EXiciuTE/Nixie-Clock-ESP32/HARDWARE/Nixie_Clock_ESP32_IN14.pdf

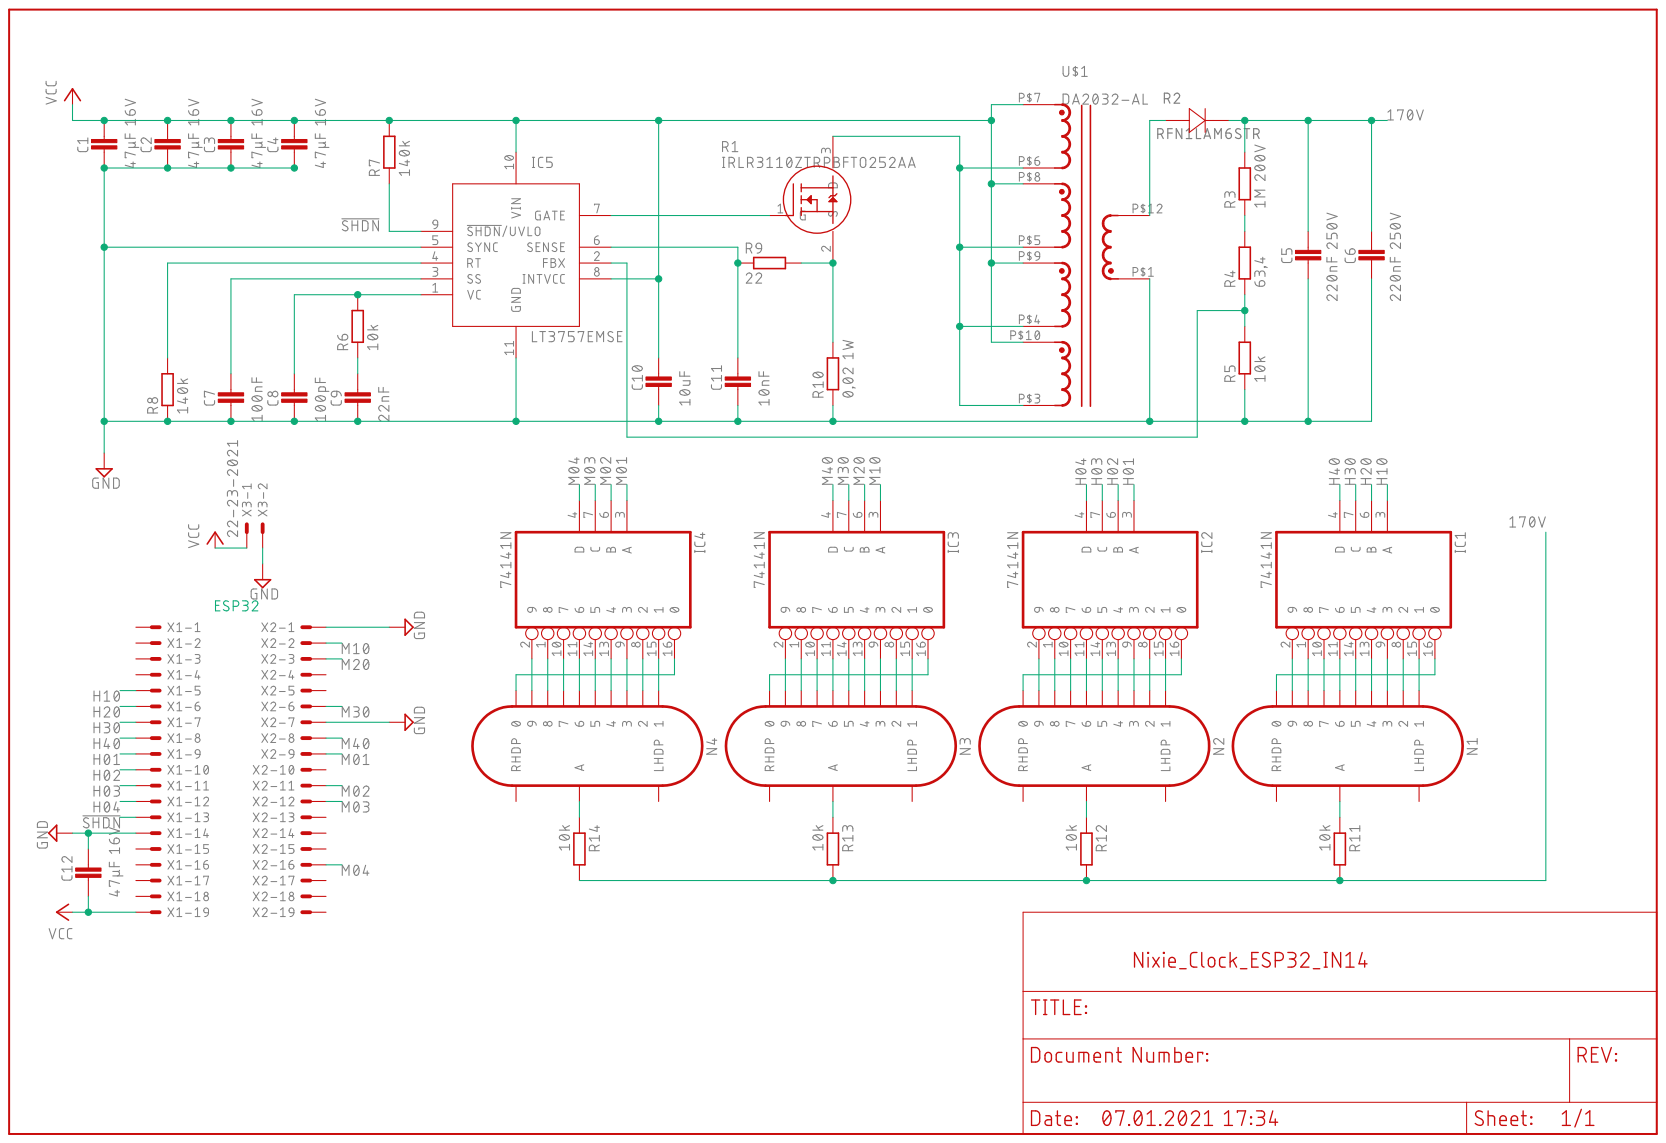
[picture p1: page 1]
