EXiciuTE/Nixie-Clock-ESP32/HARDWARE/Nixie_Clock_ESP32_IN14.brd

## EAGLE design HARDWARE/Nixie_Clock_ESP32_IN14.brd (2025-07-21)

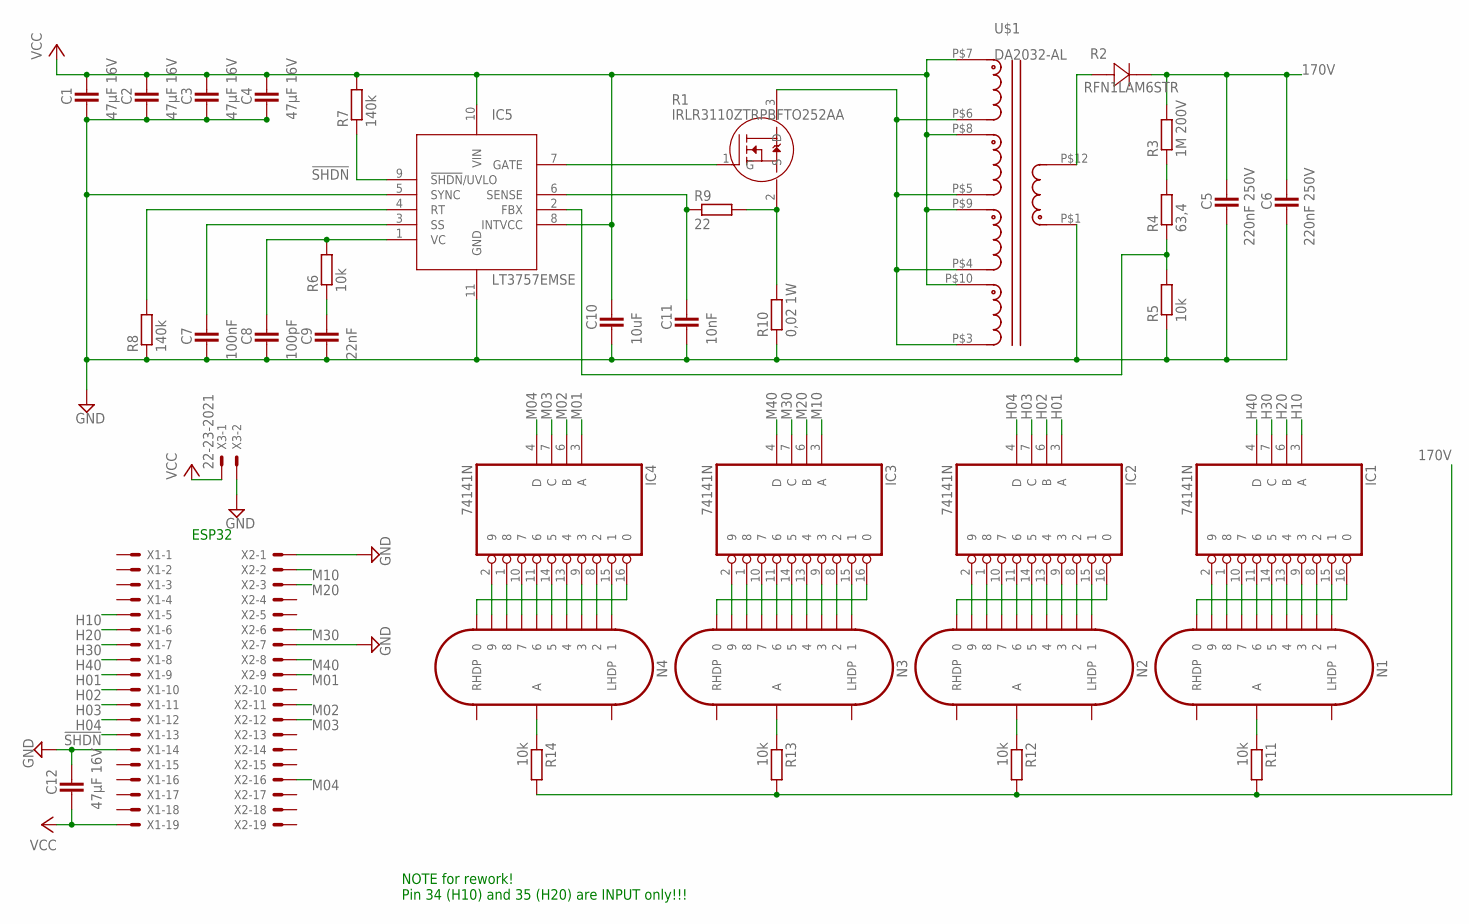
[picture p2: schematic Nixie_Clock_ESP32_IN14.sch]

Parts:
C1, C2, C3, C4, C12: 47µF 16V; C1210
C5, C6: 220nF 250V; C1206
C7: 100nF; C0805
C8: 100pF; C0805
C9: 22nF; C0805
C10: 10uF; C0805
C11: 10nF; C0805
IC1, IC2, IC3, IC4: 74141N; DIL16
IC5: LT3757EMSE; MSOP10
N1, N2, N3, N4: IN-14
R1: IRLR3110ZTRPBFTO252AA; TO252
R2: RFN1LAM6STR; DIO_RB050LAM_ROM
R3: 1M 200V; R0805
R4: 63,4; R0805
R5, R6, R11, R12, R13, R14: 10k; R0805
R7, R8: 140k; R0805
R9: 22; R1206
R10: 0,02 1W; R2010
U$1: DA2032-AL
X1, X2: C-GRID-19-70543; 70543-19
X3: 22-23-2021

Connections:
170V: C5.1, C6.1, R2.1 (0), R3.2, R11.2, R12.2, R13.2, R14.2
!SHDN: IC5.9 (!SHDN!/UVLO), R7.1, X1.13
GND: C1.2, C2.2, C3.2, C4.2, C5.2, C6.2, C7.2, C8.2, C9.2, C10.2, C11.2, C12.1, IC1.12 (GND), IC2.12 (GND), IC3.12 (GND), IC4.12 (GND), IC5.5 (SYNC), IC5.11 (GND), R5.1, R8.1, R10.1, U$1.P$1 (1), X1.14, X2.1, X2.7, X3.2
H01: IC2.3 (A), X1.9
H02: IC2.6 (B), X1.10
H03: IC2.7 (C), X1.11
H04: IC2.4 (D), X1.12
H10: IC1.3 (A), X1.5
H20: IC1.6 (B), X1.6
H30: IC1.7 (C), X1.7
H40: IC1.4 (D), X1.8
M01: IC4.3 (A), X2.9
M02: IC4.6 (B), X2.11
M03: IC4.7 (C), X2.12
M04: IC4.4 (D), X2.16
M10: IC3.3 (A), X2.2
M20: IC3.6 (B), X2.3
M30: IC3.7 (C), X2.6
M40: IC3.4 (D), X2.8
unnamed: IC1.16 (0), N1.0
unnamed: R1.3 (D), U$1.P$3 (3), U$1.P$4 (4), U$1.P$5 (5), U$1.P$6 (6)
unnamed: IC5.7 (GATE), R1.1 (G)
unnamed: C11.1, IC5.6 (SENSE), R9.1
unnamed: R1.2 (S), R9.2, R10.2
unnamed: C7.1, IC5.3 (SS)
unnamed: C8.1, IC5.1 (VC), R6.2
unnamed: C9.1, R6.1
unnamed: IC5.4 (RT), R8.2
unnamed: R3.1, R4.2
unnamed: R2.2 (1), U$1.P$12 (12)
unnamed: IC1.2 (9), N1.9
unnamed: IC5.2 (FBX), R4.1, R5.2
unnamed: IC1.1 (8), N1.8
unnamed: IC1.10 (7), N1.7
unnamed: IC1.11 (6), N1.6
unnamed: IC1.14 (5), N1.5
unnamed: IC1.13 (4), N1.4
unnamed: IC1.9 (3), N1.3
unnamed: IC1.8 (2), N1.2
unnamed: IC1.15 (1), N1.1
unnamed: IC2.16 (0), N2.0
unnamed: IC2.2 (9), N2.9
unnamed: IC2.1 (8), N2.8
unnamed: IC2.10 (7), N2.7
unnamed: IC2.11 (6), N2.6
unnamed: IC2.14 (5), N2.5
unnamed: IC2.13 (4), N2.4
unnamed: IC2.9 (3), N2.3
unnamed: IC2.8 (2), N2.2
unnamed: IC2.15 (1), N2.1
unnamed: IC3.16 (0), N3.0
unnamed: IC3.2 (9), N3.9
unnamed: IC3.1 (8), N3.8
unnamed: IC3.10 (7), N3.7
unnamed: IC3.11 (6), N3.6
unnamed: IC3.14 (5), N3.5
unnamed: IC3.13 (4), N3.4
unnamed: IC3.9 (3), N3.3
unnamed: IC3.8 (2), N3.2
unnamed: IC3.15 (1), N3.1
unnamed: IC4.16 (0), N4.0
unnamed: IC4.2 (9), N4.9
unnamed: IC4.1 (8), N4.8
unnamed: IC4.10 (7), N4.7
unnamed: IC4.11 (6), N4.6
unnamed: IC4.14 (5), N4.5
unnamed: IC4.13 (4), N4.4
unnamed: IC4.9 (3), N4.3
unnamed: IC4.8 (2), N4.2
unnamed: IC4.15 (1), N4.1
unnamed: N1.A, R11.1
unnamed: N2.A, R12.1
unnamed: N3.A, R13.1
unnamed: N4.A, R14.1
VCC: C1.1, C2.1, C3.1, C4.1, C10.1, C12.2, IC1.5 (VCC), IC2.5 (VCC), IC3.5 (VCC), IC4.5 (VCC), IC5.8 (INTVCC), IC5.10 (VIN), R7.2, U$1.P$7 (7), U$1.P$8 (8), U$1.P$9 (9), U$1.P$10 (10), X1.19, X3.1

Notes on the sheet:
ESP32
NOTE for rework! Pin 34 (H10) and 35 (H20) are INPUT only!!!

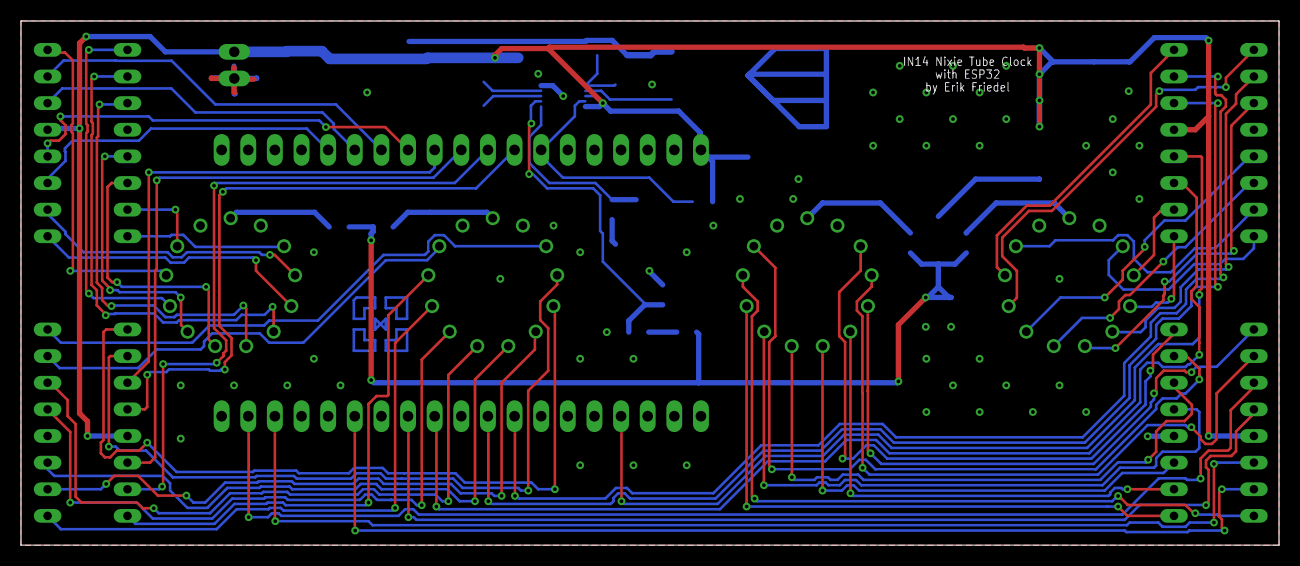
[picture p3: board Nixie_Clock_ESP32_IN14.brd from above]

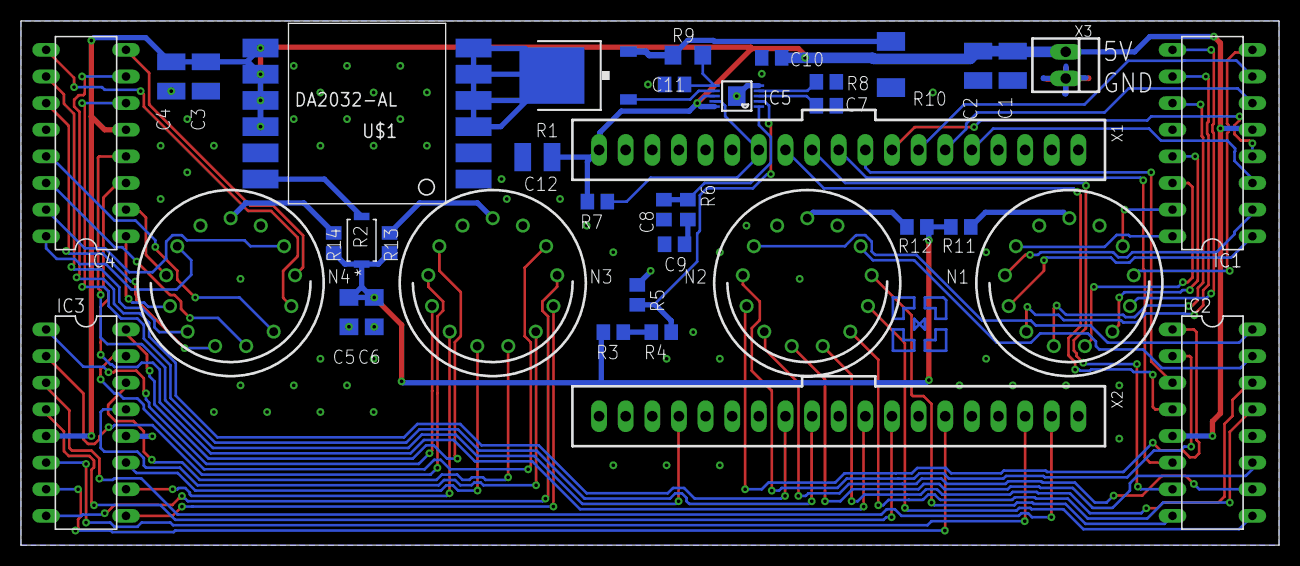
[picture p4: board Nixie_Clock_ESP32_IN14.brd from below]

Board: 2 copper layers, 120.0 x 50.0 mm, 39 parts (39 on the bottom side), 75 nets.
