EXiciuTE/Nixie-Clock-ESP32/(notices)

Notices in the files:
parts and their libraries:
COPYRIGHT: Copyright (C) 2018 Accelerated Designs. All rights reserved
